MPV247/Robot_Autobalanceo/(commit log)

2025-06-08 pines motores
2025-06-10 Correcciones en la zona muerta y el limitador de pendiente
